palazzol/rowetel/sch/dc-dc_model.pdf

L1
100uH

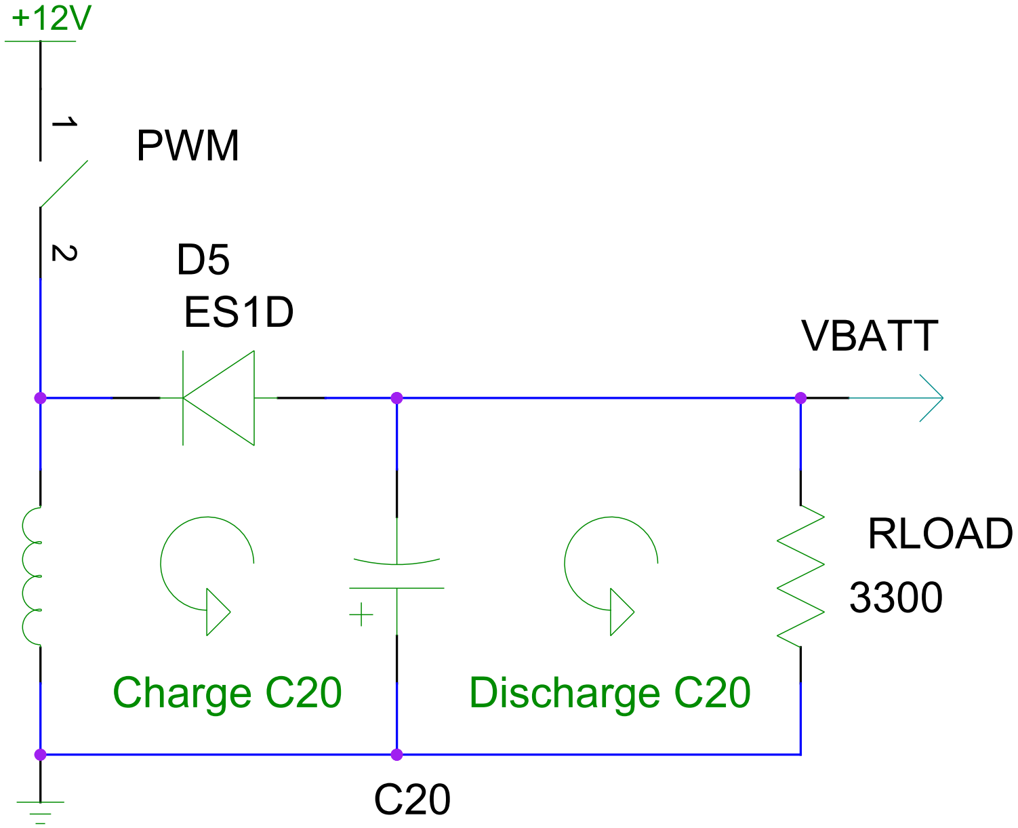
[picture p1: figure]
PWM; RLOAD; Charge C20; Discharge C20; VBATT

10uF 100V
