palazzol/rowetel/data/ATMega Schematic.pdf

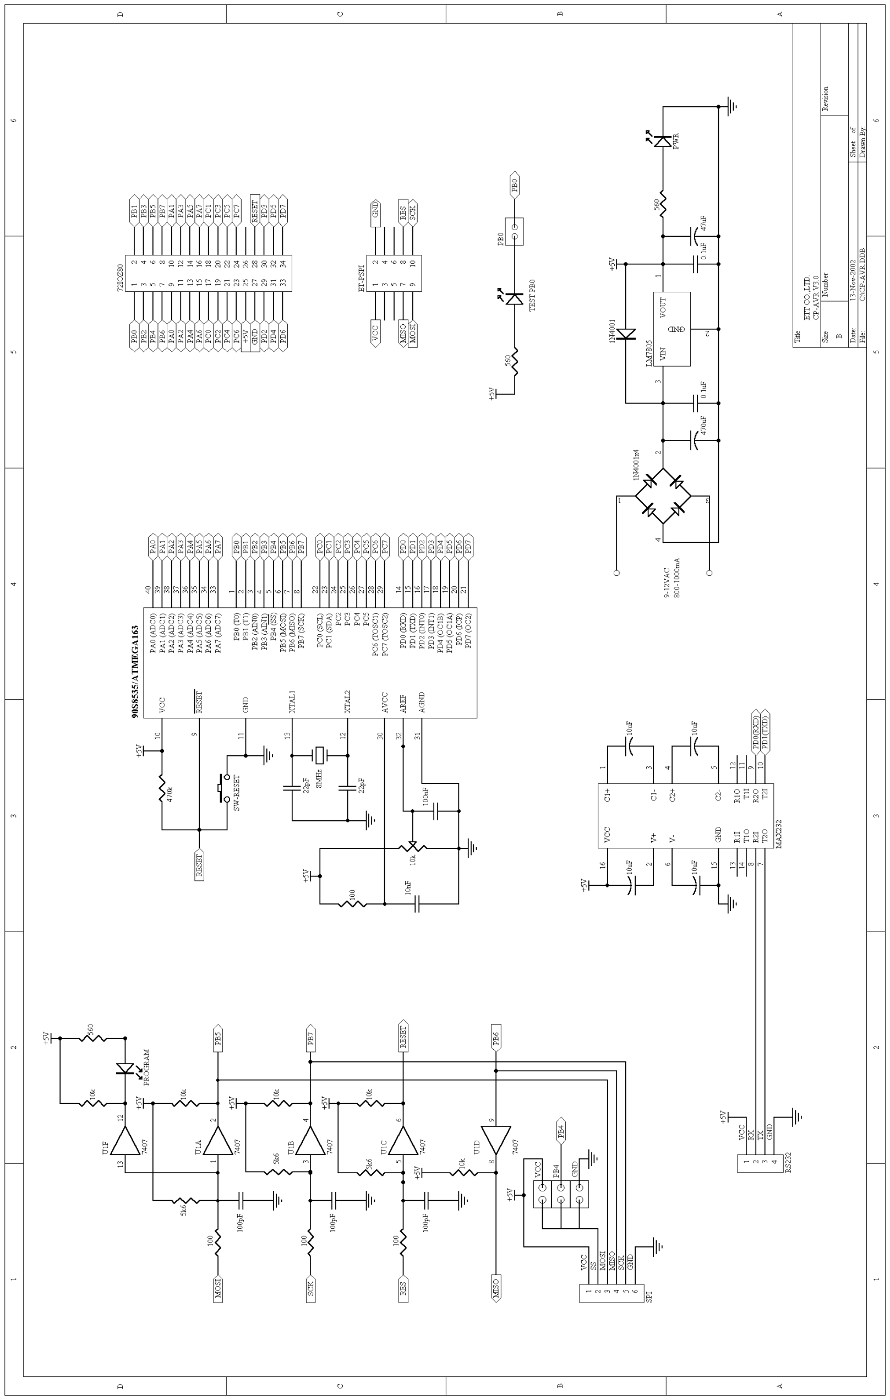
[picture p2: page 1]
