palazzol/rowetel/sch/rx_equiv_circuit.pdf

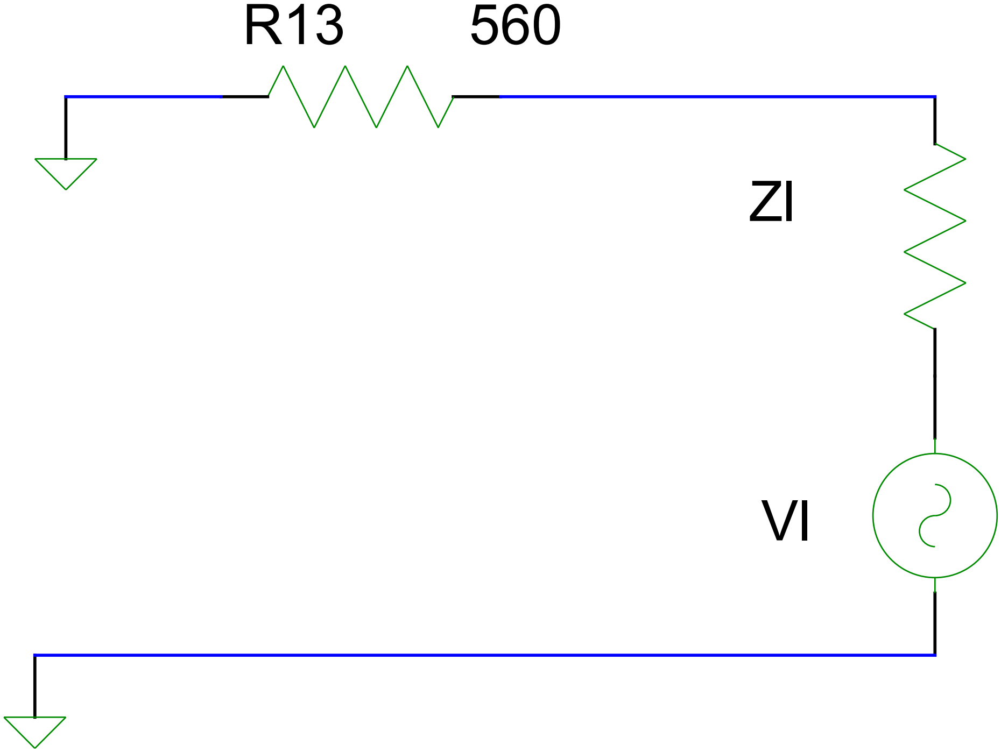
[picture p3: figure]
