palazzol/rowetel/data/ATMega Development Board Layout.pdf

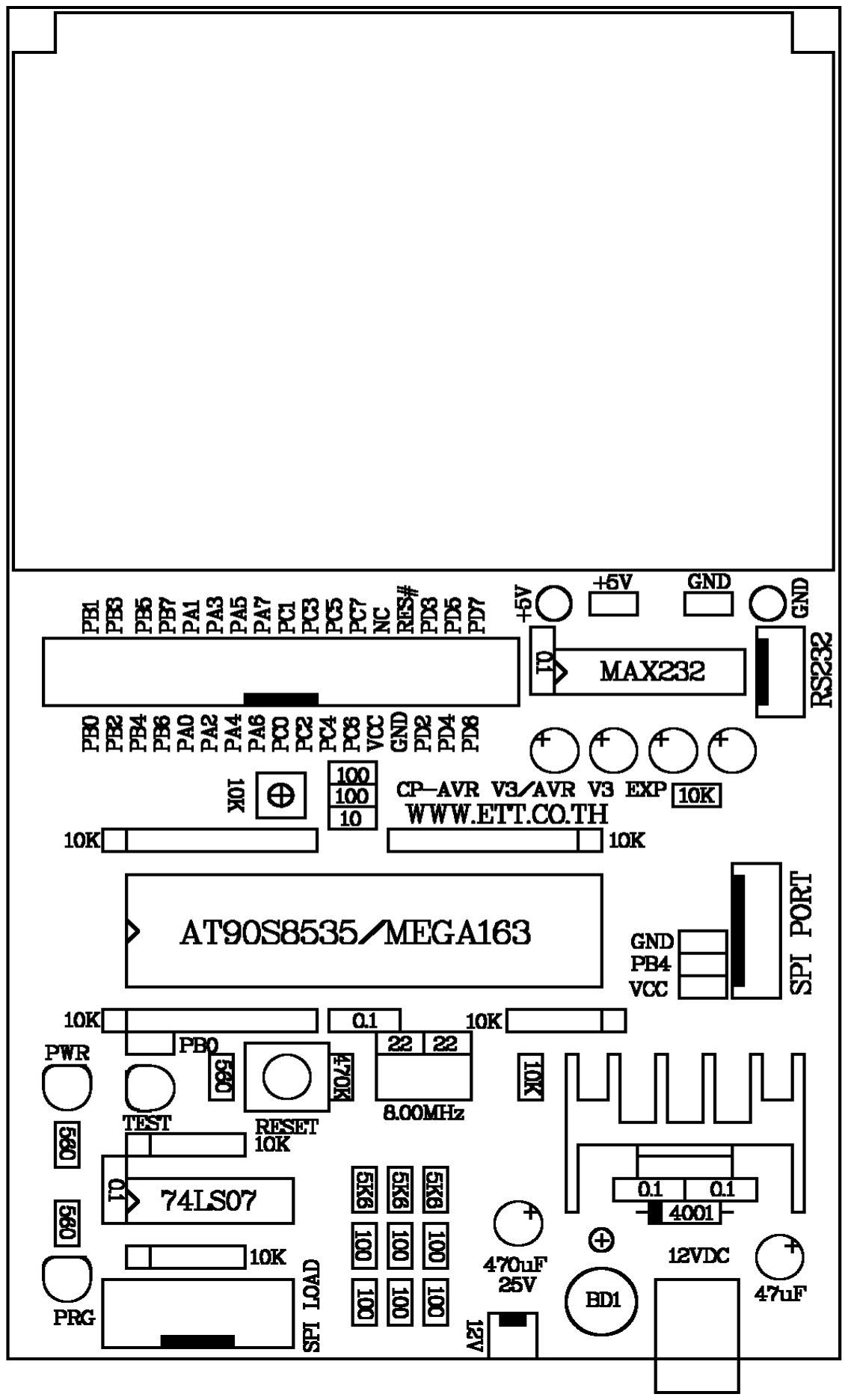
[picture p4: page 1]
