palazzol/rowetel/sch/ata.pdf

## ATmega163

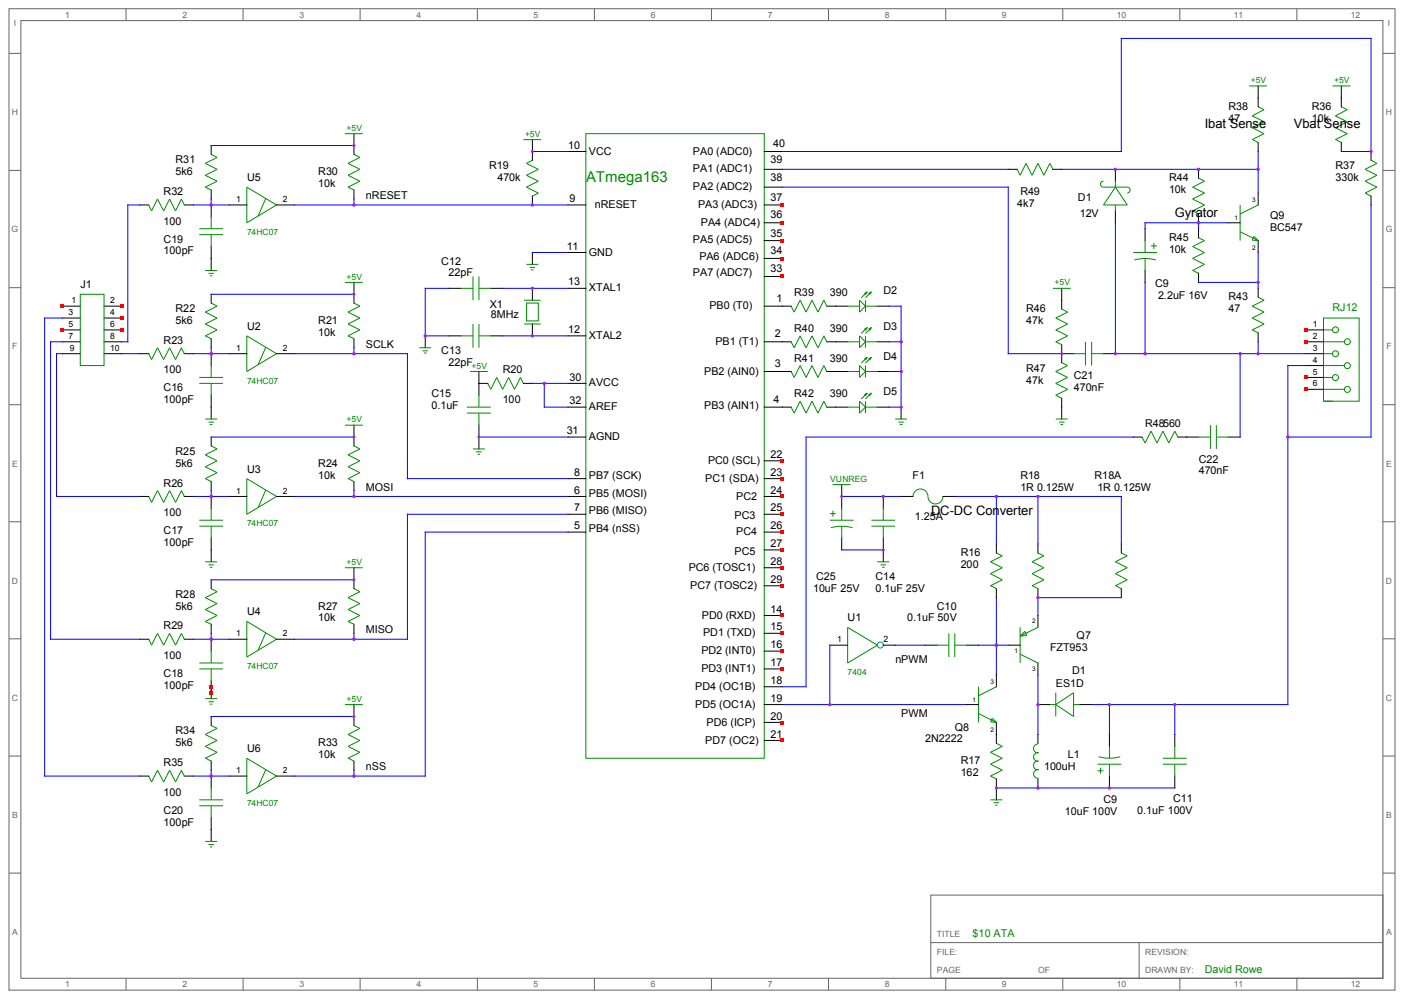
[picture p5: page 1]
