palazzol/rowetel/sch/gyrator.pdf

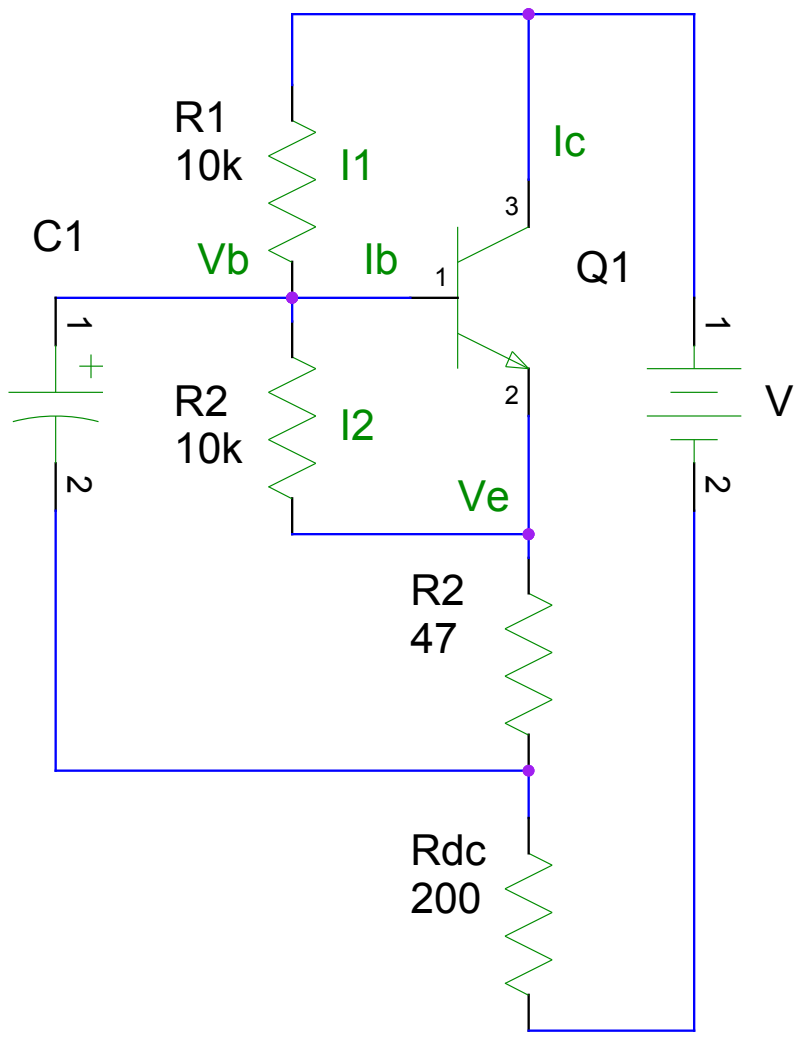
[picture p6: page 1]
Rdc 200
