palazzol/rowetel/sch/dc-dc_converter.pdf

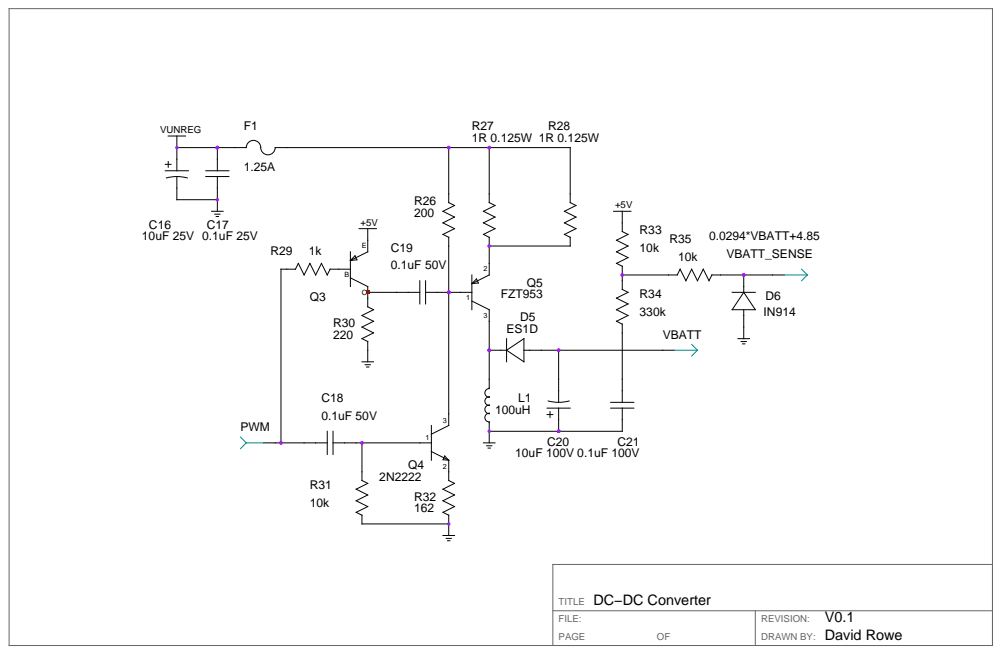
[picture p7: page 1]
