palazzol/rowetel/sch/hybrid.pdf

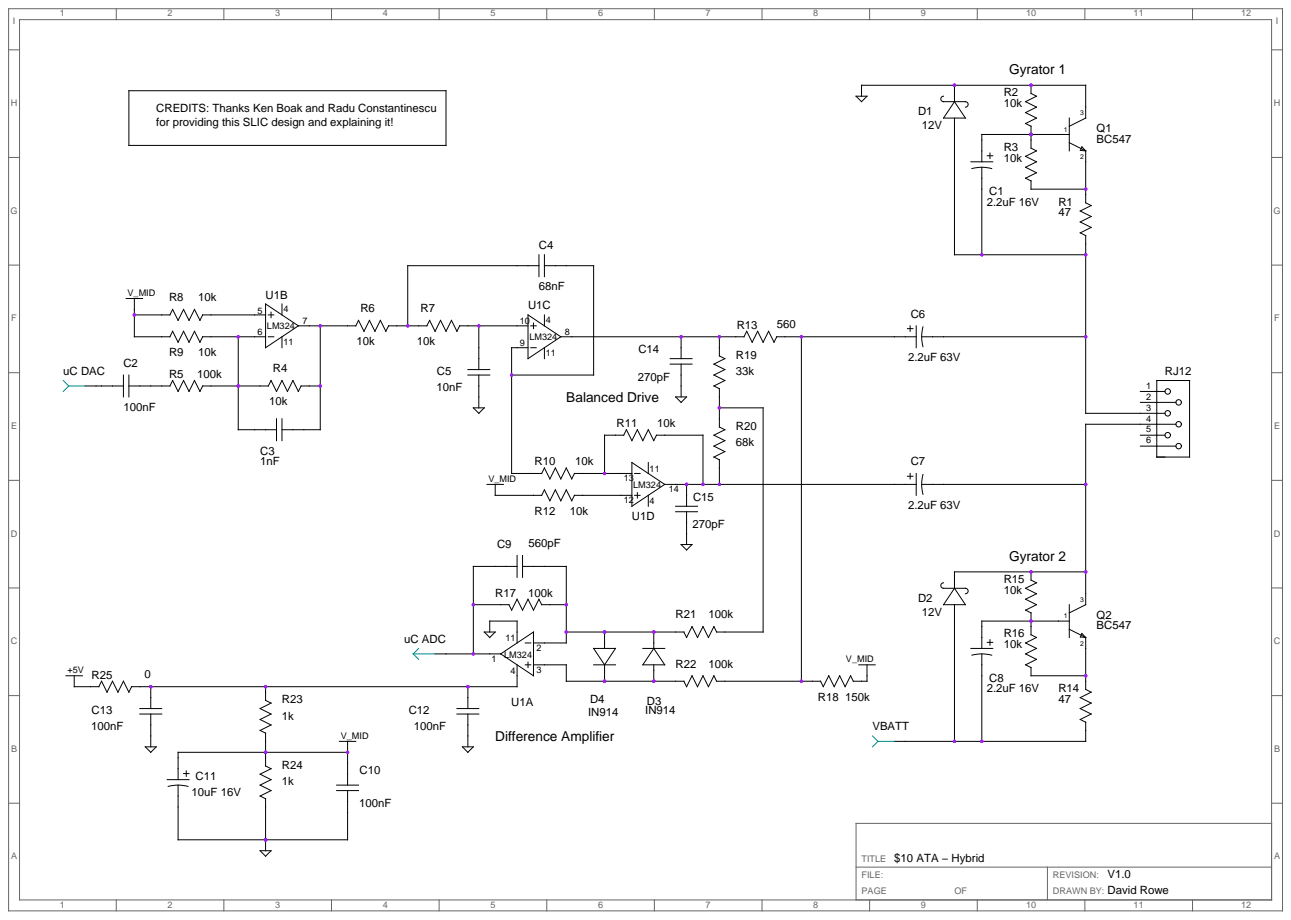
[picture p8: page 1]

CREDITS: Thanks Ken Boak and Radu Constantinescu
for providing this SLIC design and explaining it!
