palazzol/rowetel/(list of files, drawings)

Other design files:
sch/sym/fxo1.pcb
sch/sym/fxo.pcb
