palazzol/rowetel/(notices)

Notices in the files:
host/serialrecplay.c:
This program is free software; you can redistribute it and/or modify
it under the terms of the GNU Lesser General Public License version 2.1, as
published by the Free Software Foundation. This program is
